foggyhlw/fish_tank_controller_eink/pcb&sch/控制板原理图.pdf

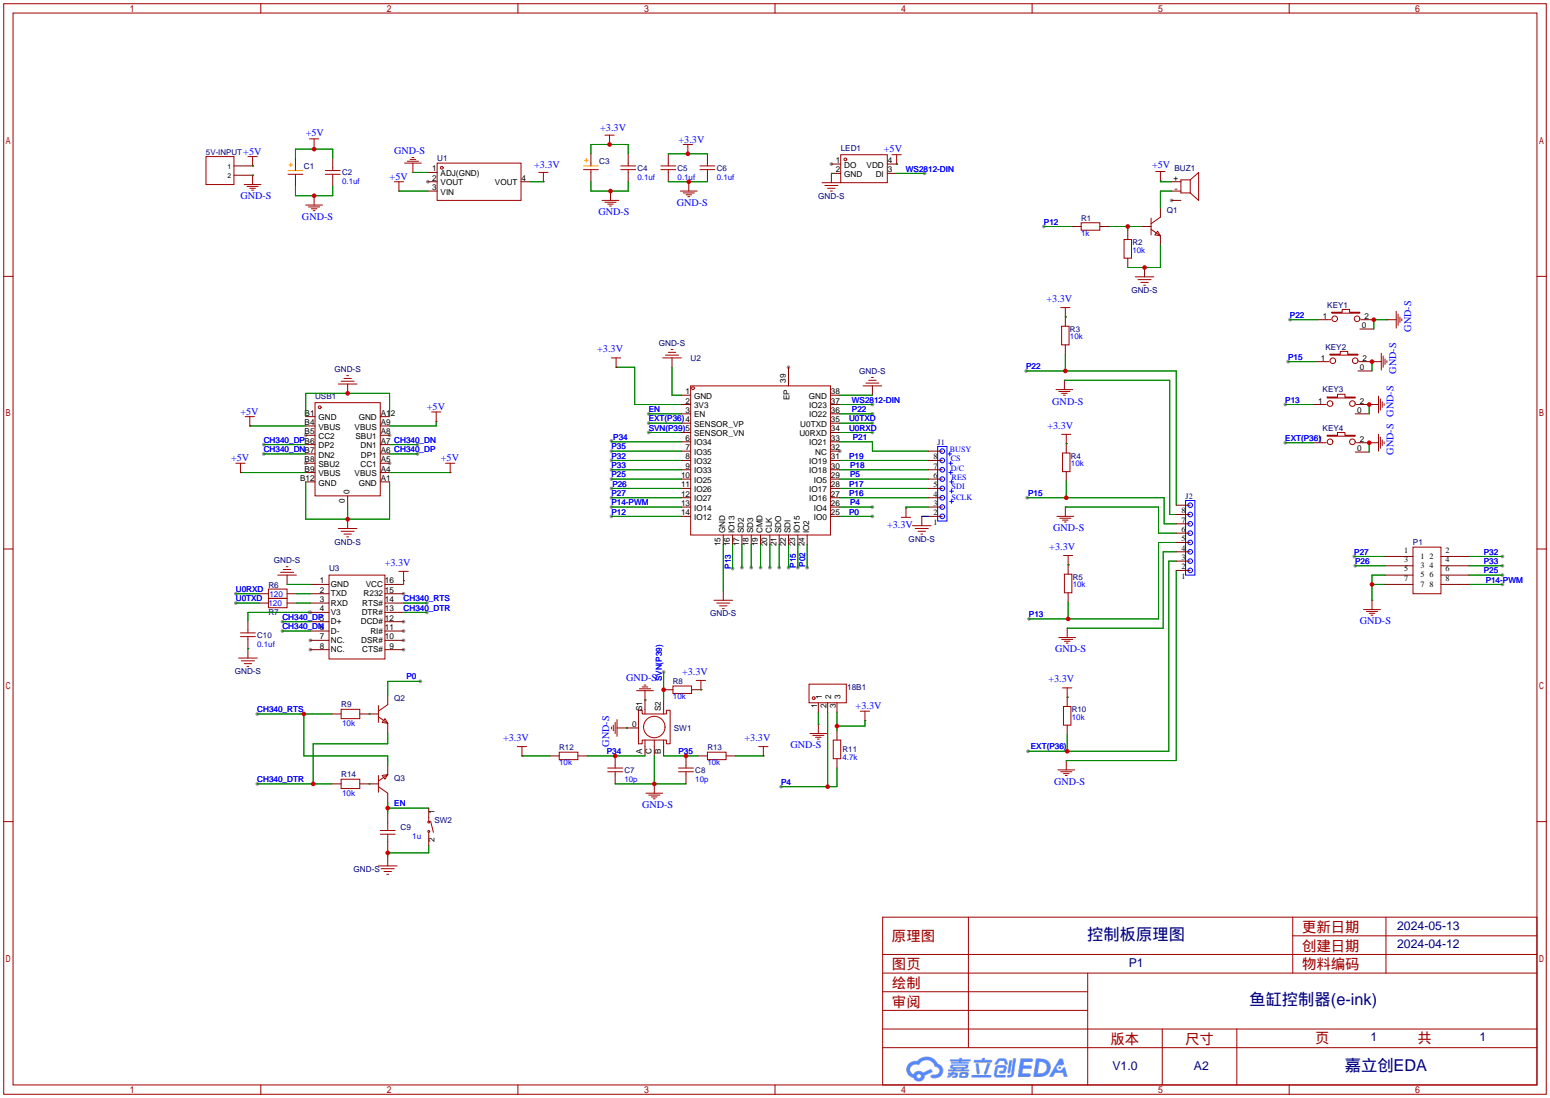
[picture p1: page 1]

GND A1 VBUS A4 CC1 A5 DP1 A6 DN1 A7 SBU1 A8 VBUS A9 GND A12
