foggyhlw/fish_tank_controller_eink/pcb&sch/墨水屏驱动板原理图.pdf

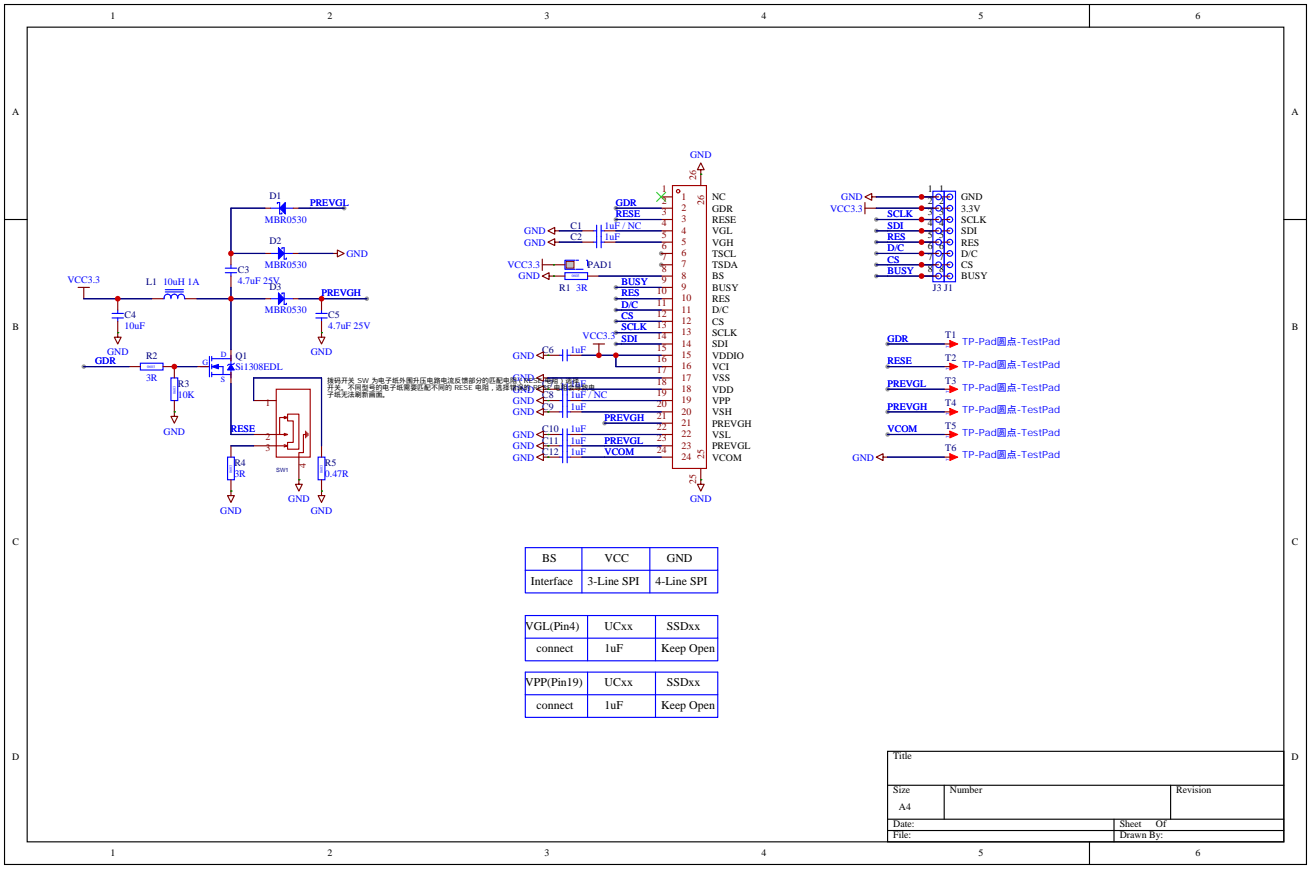
[picture p2: page 1]

拨码开关 SW 为电子纸外围升压电路电流反馈部分的匹配电阻（RESE 电阻）选择
开关。不同型号的电子纸需要匹配不同的 RESE 电阻，选择错误的 RESE 电阻会导致电
子纸无法刷新画面。

## 【要点与总结】

# 总结：

## 【历史记录】

2023.06.21 v0.1
--> v0.1：

## #. 首次建档

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
D | D
C | C
B | B
A | A
File: | Drawn By:
Date: | Sheet | Of

Size
A4
Number | Revision

Title
