foggyhlw/fish_tank_controller_eink/pcb&sch/强电版原理图.pdf

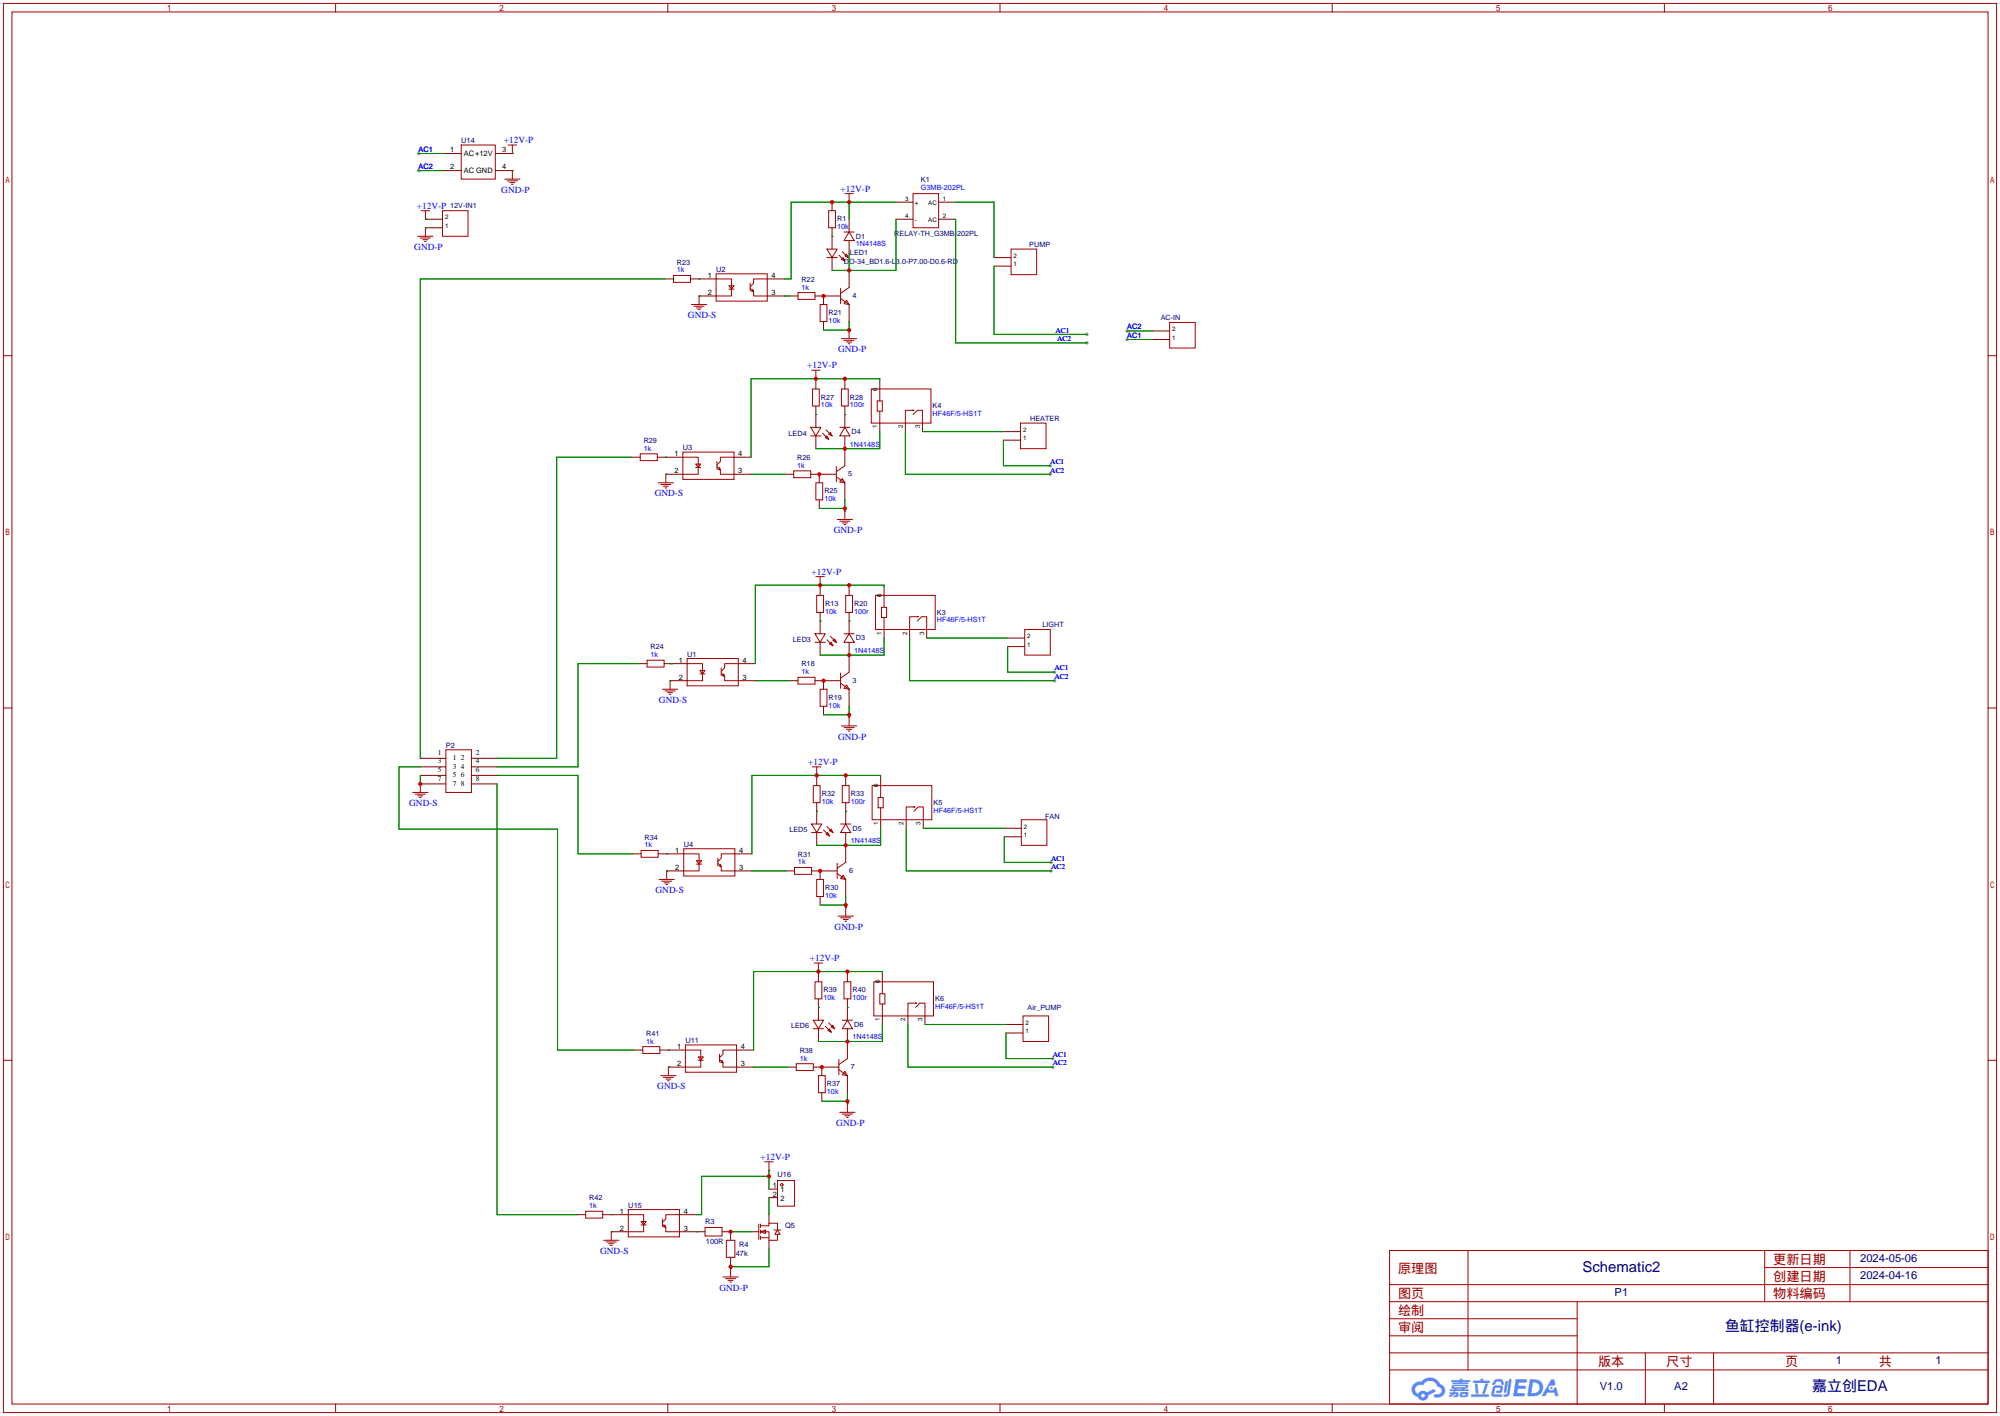
[picture p3: page 1]
