foggyhlw/fish_tank_controller_eink/(list of files, drawings)

Other design files:
pcb&sch/鱼缸控制器(e-ink).epro
