foggyhlw/fish_tank_controller_eink/(commit log)

2024-12-20 update lceda project
    [鱼缸控制器(e-ink).epro]
2024-12-20 remove ssid and passwd
    [fish-tank-controller-epaper-eink.yaml]
